aecollver/push-button-power-switch/hardware/push-button-power-switch.csv

Reference | Qty | Value | Manufacturer Part Number | Datasheet | Footprint | DNP
C1 | 1 | 1u | CC0805KFX7R8BB105 | https://www.mouser.com/datasheet/3/508/1/UPY-GPHC_X7R_6.3V-to-250V_24.pdf | Capacitor_SMD:C_0805_2012Metric_Pad1.18x1.45mm_HandSolder
C2 | 1 | 0.01u | CC0805KRX7R0BB103 | https://www.mouser.com/datasheet/3/508/1/UPY_GPHC_X7R_6_3V_TO_250V.pdf | Capacitor_SMD:C_0805_2012Metric_Pad1.18x1.45mm_HandSolder
C3 | 1 | 0.47u | CC0805KKX7R9BB474 | https://www.mouser.com/datasheet/3/508/1/UPY_GPHC_X7R_6_3V_TO_250V.pdf | Capacitor_SMD:C_0805_2012Metric_Pad1.18x1.45mm_HandSolder
C4 | 1 | 2.2u | CC0805KKX7R8BB225 | https://www.mouser.com/datasheet/3/508/1/UPY_GPHC_X7R_6_3V_TO_250V.pdf | Capacitor_SMD:C_0805_2012Metric_Pad1.18x1.45mm_HandSolder
D1 | 1 | 8.2 V | BZT52-B8V2S_R1_00001 | https://www.mouser.com/datasheet/3/3736/1/2221C87668F767AC35B3175E1CD9F15D10F52FB423EF1DA7655068B564B00BFC.pdf | Diode_SMD:D_SOD-323_HandSoldering
J1,J2 | 2 | T50201500000G |  | https://www.mouser.co.uk/datasheet/2/18/9t_Oefo5So2A-1379158.pdf | SamacSys:T50201500000G
Q1 | 1 | Load Switch MOSFET | DMP3028LSD-13 | https://www.diodes.com//assets/Datasheets/DMP3028LSD.pdf | SamacSys:SOIC127P600X170-8N
Q2 | 1 | Latch MOSFET | MMFTP3401-AQ | https://diotec.com/request/datasheet/mmftp3401.pdf | Package_TO_SOT_SMD:SOT-23_Handsoldering
Q3,Q4,Q5 | 3 | NPN | MMBT3904 | https://diotec.com/request/datasheet/mmbt3904.pdf | Package_TO_SOT_SMD:SOT-23_Handsoldering
R1,R7,R8 | 3 | 1k | RC0805FR-071KL | https://www.mouser.com/catalog/specsheets/YAGEO_PYu_RC_Group_51_RoHS_L_12.pdf | Resistor_SMD:R_0805_2012Metric_Pad1.20x1.40mm_HandSolder
R2,R3,R4,R5,R9,R11 | 6 | 100k | RC0805FR-07100KL | https://www.mouser.com/catalog/specsheets/YAGEO_PYu_RC_Group_51_RoHS_L_12.pdf | Resistor_SMD:R_0805_2012Metric_Pad1.20x1.40mm_HandSolder
R6,R10 | 2 | 10k | RC0805FR-0710KL | https://www.mouser.com/catalog/specsheets/YAGEO_PYu_RC_Group_51_RoHS_L_12.pdf | Resistor_SMD:R_0805_2012Metric_Pad1.20x1.40mm_HandSolder
SW1 | 1 | FSM101 / 1437565-3 | FSM101 | https://www.te.com/en/product-1437565-3.html | SamacSys:FSM101
