aecollver/push-button-power-switch/hardware/push-button-power-switch.kicad_sch

## KiCad design hardware/push-button-power-switch.kicad_sch (2026-11-11)

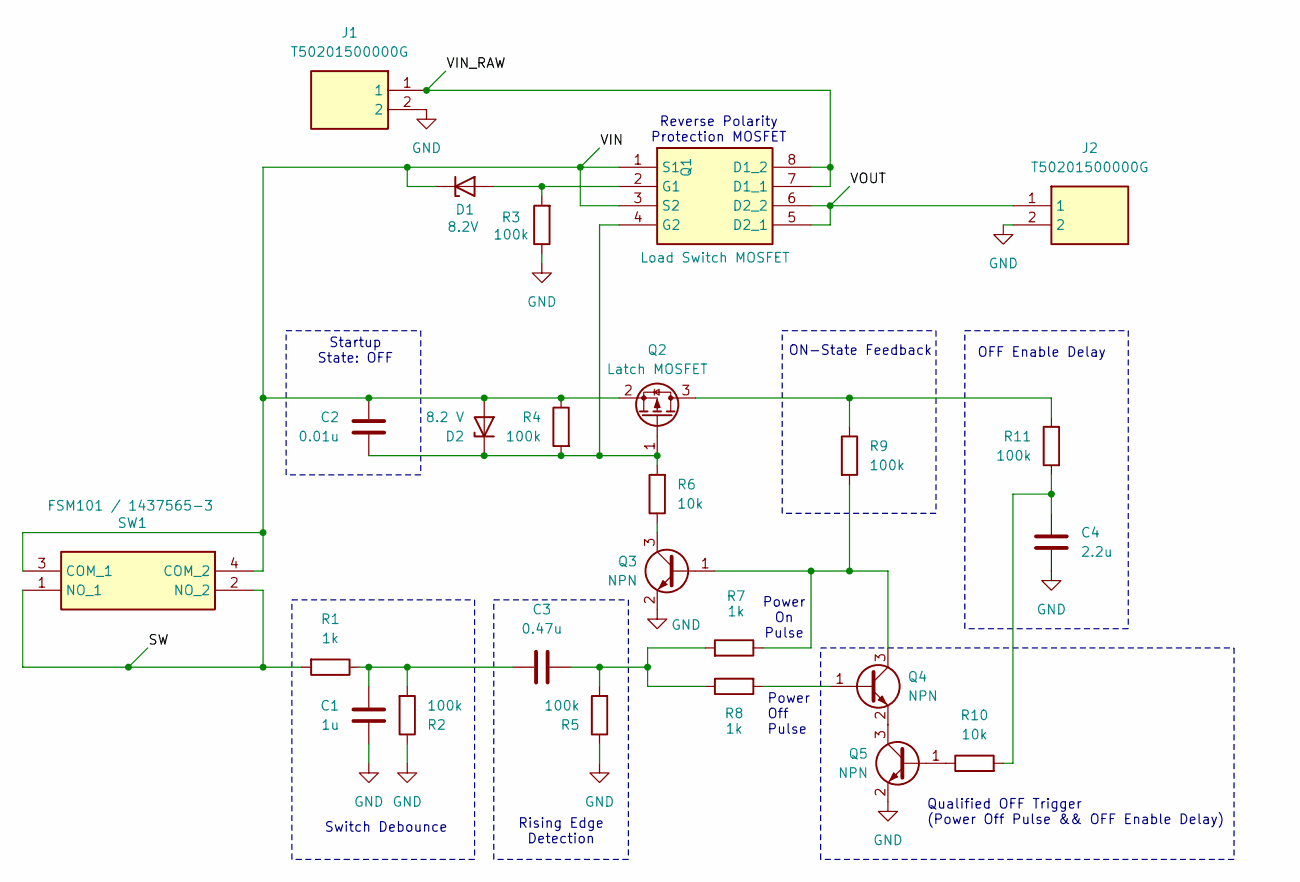
[picture p3: schematic push-button-power-switch.kicad_sch]

Parts:
C1: 1u; C_0805_2012Metric_Pad1.18x1.45mm_HandSolder; Manufacturer Part Number CC0805KFX7R8BB105
C2: 0.01u; C_0805_2012Metric_Pad1.18x1.45mm_HandSolder; Manufacturer Part Number CC0805KRX7R0BB103
C3: 0.47u; C_0805_2012Metric_Pad1.18x1.45mm_HandSolder; Manufacturer Part Number CC0805KKX7R9BB474
C4: 2.2u; C_0805_2012Metric_Pad1.18x1.45mm_HandSolder; Manufacturer Part Number CC0805KKX7R8BB225
D1: 8.2V; D_SOD-323_HandSoldering; Manufacturer Part Number BZT52-B8V2S_R1_00001
D2: 8.2 V; D_SOD-323_HandSoldering; Manufacturer Part Number BZT52-B8V2S_R1_00001
J1, J2: T50201500000G; Mouser Part Number 649-T502015000J0G
Q1: Load Switch MOSFET; SOIC127P600X170-8N; Manufacturer Part Number DMP3028LSD-13; Mouser Part Number 621-DMP3028LSD-13
Q2: Latch MOSFET; SOT-23_Handsoldering; Manufacturer Part Number MMFTP3401-AQ
Q3, Q4, Q5: NPN; SOT-23_Handsoldering; Manufacturer Part Number MMBT3904
R1, R7, R8: 1k; R_0805_2012Metric_Pad1.20x1.40mm_HandSolder; Manufacturer Part Number RC0805FR-071KL
R2, R3, R4, R5, R9, R11: 100k; R_0805_2012Metric_Pad1.20x1.40mm_HandSolder; Manufacturer Part Number RC0805FR-07100KL
R6, R10: 10k; R_0805_2012Metric_Pad1.20x1.40mm_HandSolder; Manufacturer Part Number RC0805FR-0710KL
SW1: FSM101 / 1437565-3; FSM101; Manufacturer Part Number FSM101; Mouser Part Number 506-FSM101

Connections:
GND: C1.2, C4.2, J1.2, J2.2, Q3.2 (E), Q5.2 (E), R2.1, R3.1, R5.1
unnamed: C1.1, C3.1, R1.1, R2.2
unnamed: C2.2, D2.1 (K), Q1.4 (G2), Q2.1 (G), R4.2, R6.2
unnamed: C3.2, R5.2, R7.2, R8.1
unnamed: C4.1, R10.2, R11.2
unnamed: D1.2 (A), Q1.2 (G1), R3.2
unnamed: Q2.3 (D), R9.1, R11.1
unnamed: Q3.1 (B), Q4.3 (C), R7.1, R9.2
unnamed: Q3.3 (C), R6.1
unnamed: Q4.1 (B), R8.2
unnamed: Q4.2 (E), Q5.3 (C)
unnamed: Q5.1 (B), R10.1
SW: R1.2, SW1.1 (NO_1), SW1.2 (NO_2)
VIN: C2.1, D1.1 (K), D2.2 (A), Q1.1 (S1), Q1.3 (S2), Q2.2 (S), R4.1, SW1.3 (COM_1), SW1.4 (COM_2)
VIN_RAW: J1.1, Q1.7 (D1_1), Q1.8 (D1_2)
VOUT: J2.1, Q1.5 (D2_1), Q1.6 (D2_2)

Notes on the sheet:
OFF Enable Delay
Qualified OFF Trigger (Power Off Pulse && OFF Enable Delay)
ON-State Feedback
Power Off Pulse
Reverse Polarity Protection MOSFET
Power On Pulse
Rising Edge Detection
Startup State: OFF
Switch Debounce
