aecollver/push-button-power-switch/simulation/push-button-power-switch-simulation.kicad_sch

## KiCad design simulation/push-button-power-switch-simulation.kicad_sch (2026-11-11)

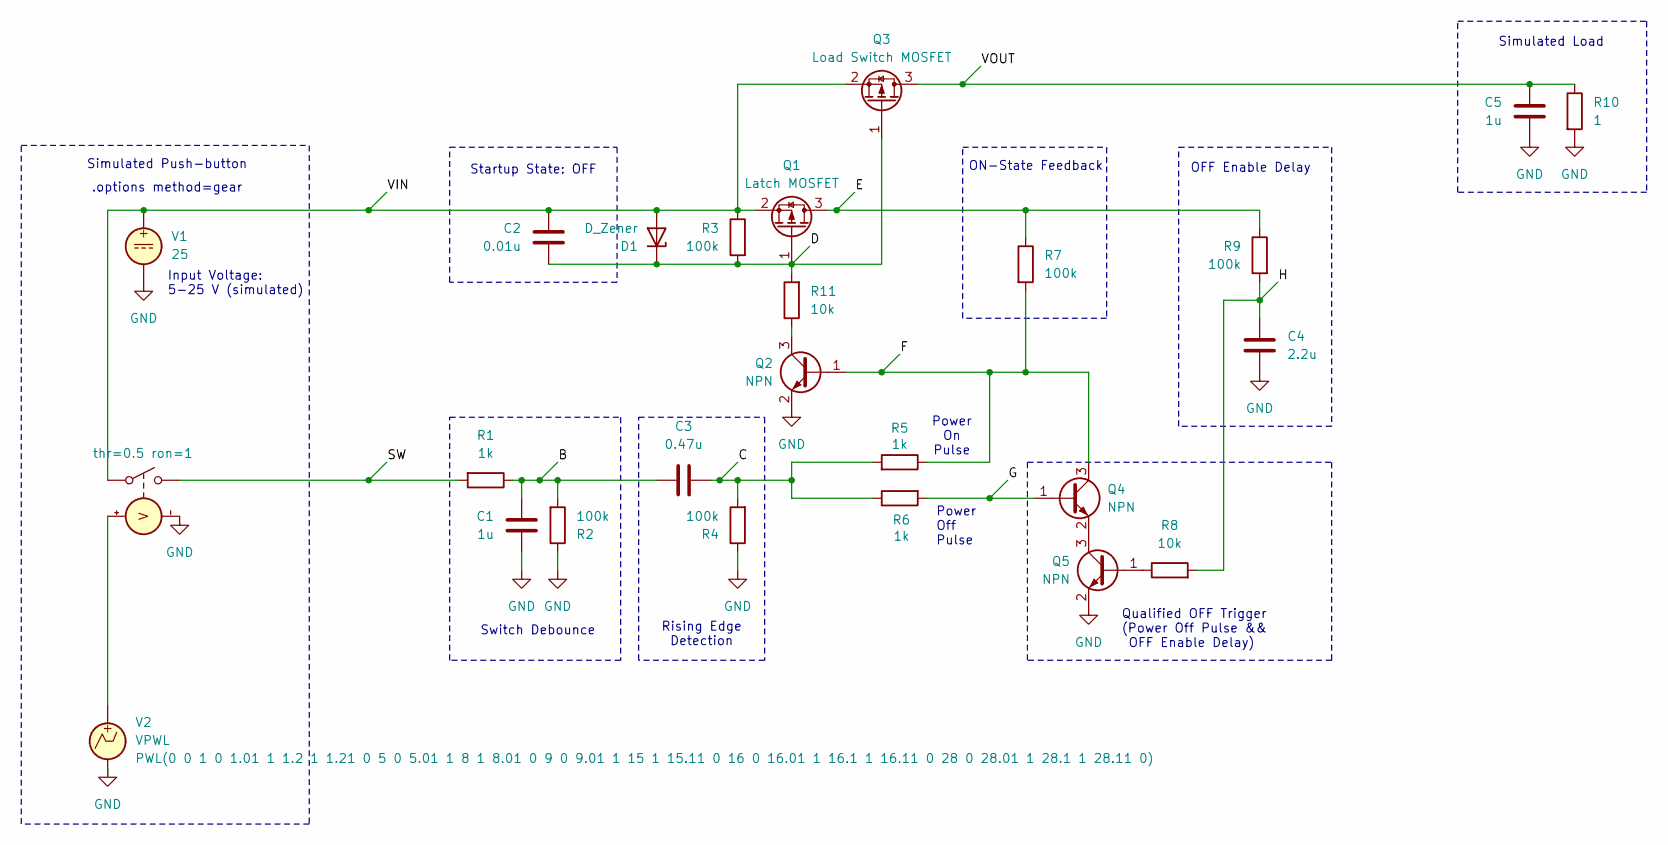
[picture p4: schematic push-button-power-switch-simulation.kicad_sch]

Parts:
C1, C5: 1u
C2: 0.01u
C3: 0.47u
C4: 2.2u
D1: D_Zener; Texas_DSBGA-8_0.9x1.9mm_Layout2x4_P0.5mm
Q1: Latch MOSFET
Q2, Q4, Q5: NPN
Q3: Load Switch MOSFET
R1, R5, R6: 1k
R2, R3, R4, R7, R9: 100k
R8, R11: 10k
R10: 1
S1: SWITCH
V1: 25
V2: VPWL

Connections:
B: C1.1, C3.1, R1.1, R2.2
C: C3.2, R4.2, R5.2, R6.1
D: C2.2, D1.1 (K), Q1.1 (G), Q3.1 (G), R3.2, R11.2
E: Q1.3 (D), R7.1, R9.1
F: Q2.1 (B), Q4.3 (C), R5.1, R7.2
G: Q4.1 (B), R6.2
GND: C1.2, C4.2, C5.2, Q2.2 (E), Q5.2 (E), R2.1, R4.1, R10.2, S1.4 (C-), V1.2, V2.2
H: C4.1, R8.2, R9.2
unnamed: Q2.3 (C), R11.1
unnamed: Q4.2 (E), Q5.3 (C)
unnamed: Q5.1 (B), R8.1
unnamed: S1.3 (C+), V2.1
SW: R1.2, S1.2 (N-)
VIN: C2.1, D1.2 (A), Q1.2 (S), Q3.2 (S), R3.1, S1.1 (N+), V1.1
VOUT: C5.1, Q3.3 (D), R10.1

Notes on the sheet:
OFF Enable Delay
Qualified OFF Trigger (Power Off Pulse && OFF Enable Delay)
ON-State Feedback
.options method=gear
Power Off Pulse
Simulated Push-button
Input Voltage: 5-25 V (simulated)
Rising Edge Detection
Power On Pulse
Startup State: OFF
Simulated Load
Switch Debounce
