aecollver/push-button-power-switch/(commit log)

2026-11-10 Initial release: Push-button power switch reference design
    [push-button-power-switch.kicad_sch]
2026-11-11 Assign components and split simulation into a separate KiCad project
    Select a dual-channel power MOSFET to provide reverse-polarity protection and load switching. Add Zener diodes to protect the MOSFET gates.
    [push-button-power-switch-simulation.kicad_sch, push-button-power-switch.csv, push-button-power-switch.kicad_sch]
